TjarkG/Anemometer/README.md

# Anemometer

Ultrasonic Anemometer based on an cheap distance Sensors
