TjarkG/Anemometer/PCB/Hc_sr04_schematics.png

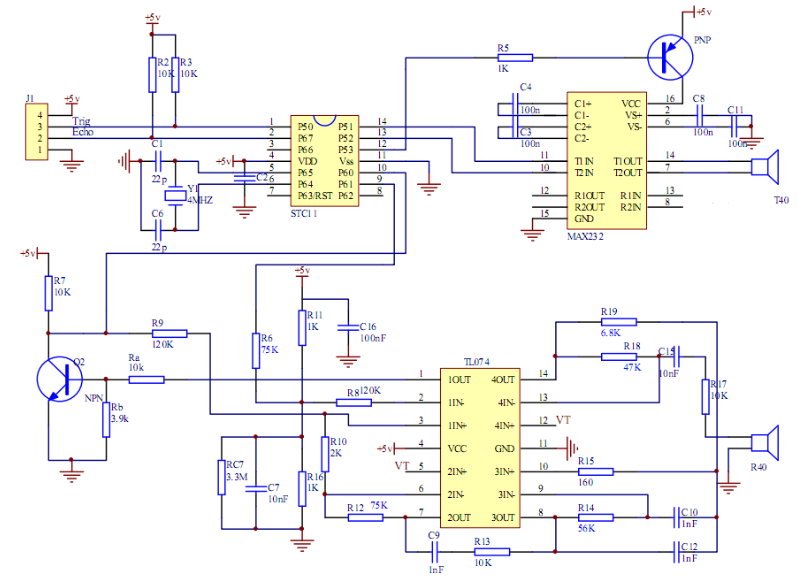
PCB/Hc_sr04_schematics.png
