TjarkG/Anemometer/PCB/HC-SR04 Case.stl

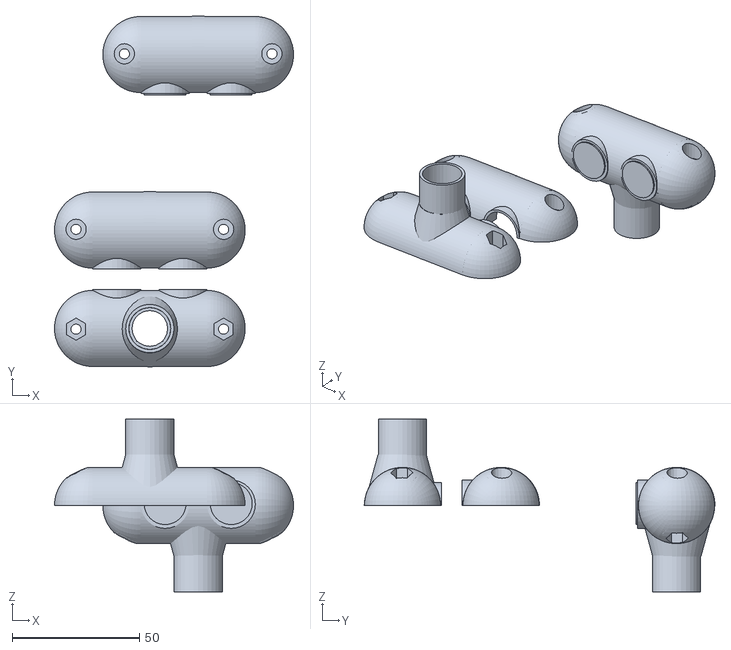
[picture p2: CAD file, 2022-01-11]
PCB/HC-SR04 Case.stl
94.0 x 138.0 x 68.0
