TjarkG/Anemometer/PCB/AnemometerTHT.brd

## EAGLE design PCB/AnemometerTHT.brd (2021-12-28)

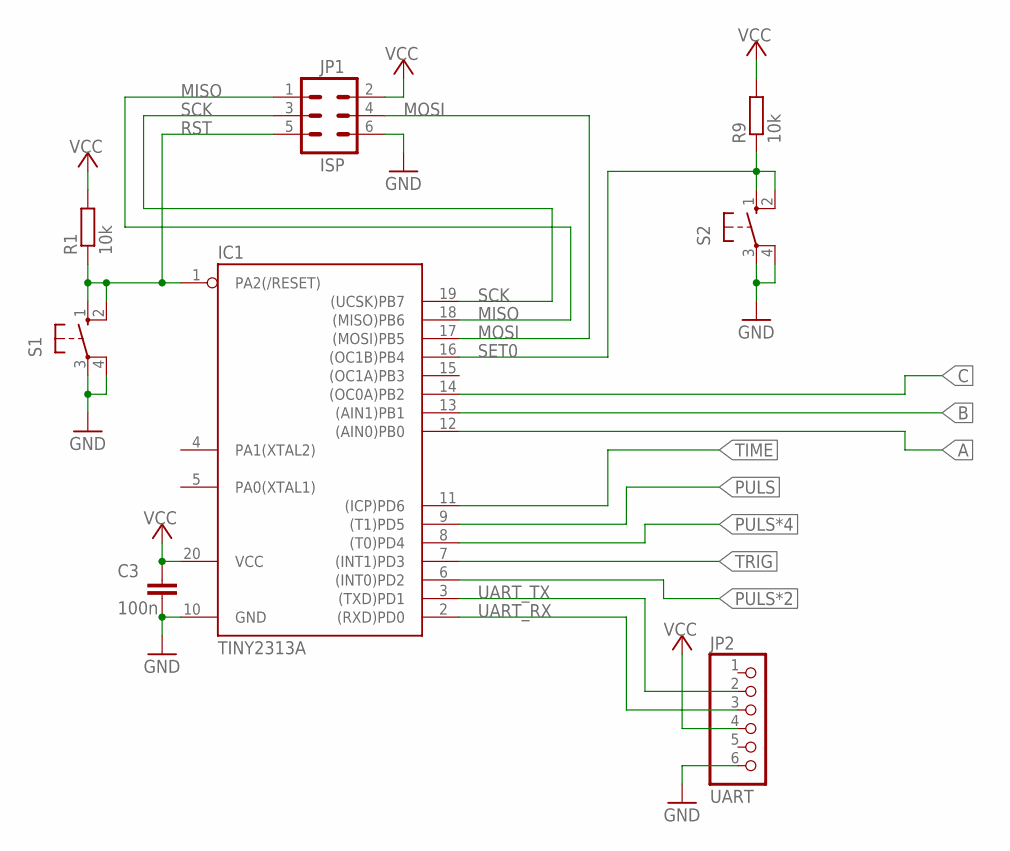
[picture p3: schematic AnemometerTHT.sch, sheet 1, microcontroller]

Parts:
C3: 100n; C050-030X075
IC1: TINY2313A; DIL20
JP1: ISP; ML6
JP2: UART; 1X06
R1, R9: 10k; 0204/7
S1, S2: 10-XX; B3F-10XX

Connections:
A: IC1.12 ((AIN0)PB0); also elsewhere on the board
B: IC1.13 ((AIN1)PB1); also elsewhere on the board
C: IC1.14 ((OC0A)PB2); also elsewhere on the board
GND: C3.2, IC1.10 (GND), JP1.6, JP2.6, S1.3, S1.4 (P1), S2.3, S2.4 (P1); also elsewhere on the board
MISO: IC1.18 ((MISO)PB6), JP1.1
MOSI: IC1.17 ((MOSI)PB5), JP1.4
PULS: IC1.9 ((T1)PD5); also elsewhere on the board
PULS*2: IC1.6 ((INT0)PD2); also elsewhere on the board
PULS*4: IC1.8 ((T0)PD4); also elsewhere on the board
RST: IC1.1 (PA2(/RESET)), JP1.5, R1.1, S1.1 (S), S1.2 (S1)
SCK: IC1.19 ((UCSK)PB7), JP1.3
SET0: IC1.16 ((OC1B)PB4), R9.1, S2.1 (S), S2.2 (S1)
TIME: IC1.11 ((ICP)PD6); also elsewhere on the board
TRIG: IC1.7 ((INT1)PD3); also elsewhere on the board
UART_RX: IC1.2 ((RXD)PD0), JP2.3
UART_TX: IC1.3 ((TXD)PD1), JP2.2
VCC: C3.1, IC1.20 (VCC), JP1.2, JP2.4, R1.2, R9.2; also elsewhere on the board

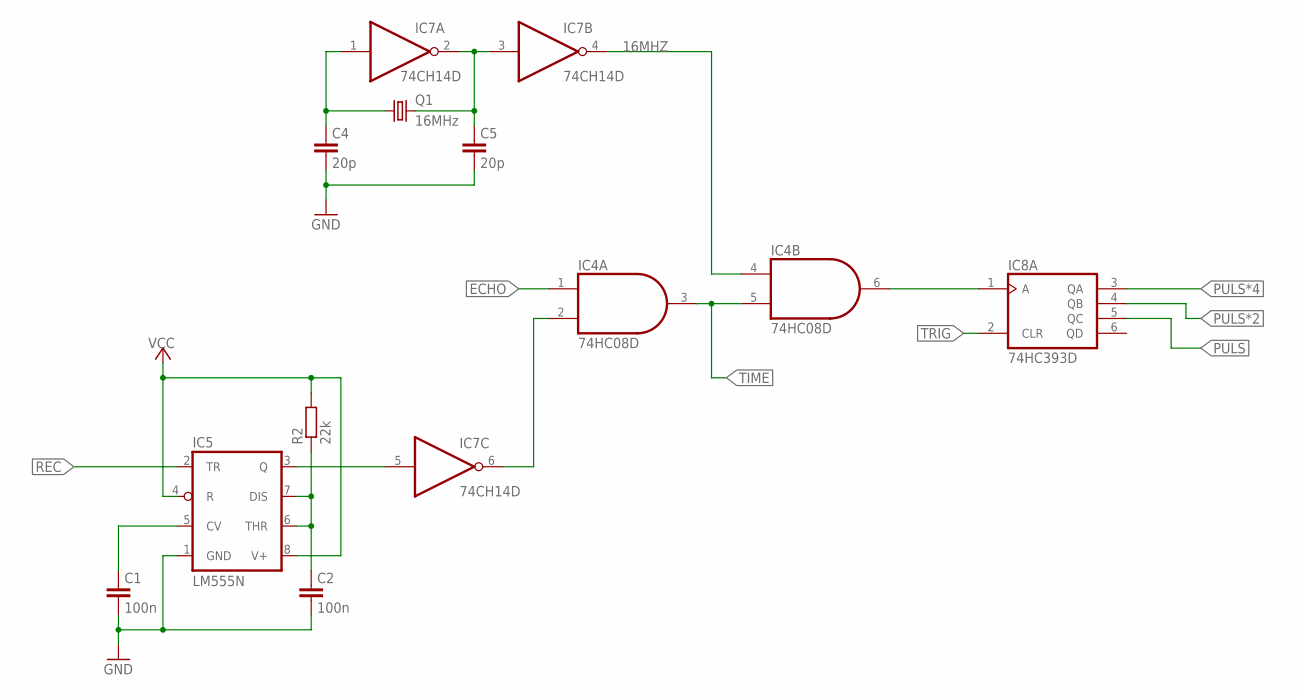
[picture p4: schematic AnemometerTHT.sch, sheet 2, puls generation]

Parts:
C1, C2: 100n; C050-030X075
C4, C5: 20p; C050-030X075
IC4: 74HC08D; DIL14
IC5: LM555N; DIL08
IC7: 74CH14D; DIL14
IC8: 74HC393D; DIL14
Q1: 16MHz; HC49U70
R2: 22k; 0204/7

Connections:
16MHZ: IC4.4 (I0), IC7.4 (O)
ECHO: IC4.1 (I0); also elsewhere on the board
GND: C1.2, C2.2, C4.2, C5.2, IC5.1 (GND); also elsewhere on the board
unnamed: IC5.3 (Q), IC7.5 (I)
unnamed: C1.1, IC5.5 (CV)
unnamed: IC4.6 (O), IC8.1 (A)
unnamed: C2.1, IC5.6 (THR), IC5.7 (DIS), R2.1
unnamed: IC4.2 (I1), IC7.6 (O)
unnamed: C4.1, IC7.1 (I), Q1.1
unnamed: C5.1, IC7.2 (O), IC7.3 (I), Q1.2
PULS: IC8.5 (QC); also elsewhere on the board
PULS*2: IC8.4 (QB); also elsewhere on the board
PULS*4: IC8.3 (QA); also elsewhere on the board
REC: IC5.2 (TR); also elsewhere on the board
TIME: IC4.3 (O), IC4.5 (I1); also elsewhere on the board
TRIG: IC8.2 (CLR); also elsewhere on the board
VCC: IC5.4 (R), IC5.8 (V+), R2.2; also elsewhere on the board

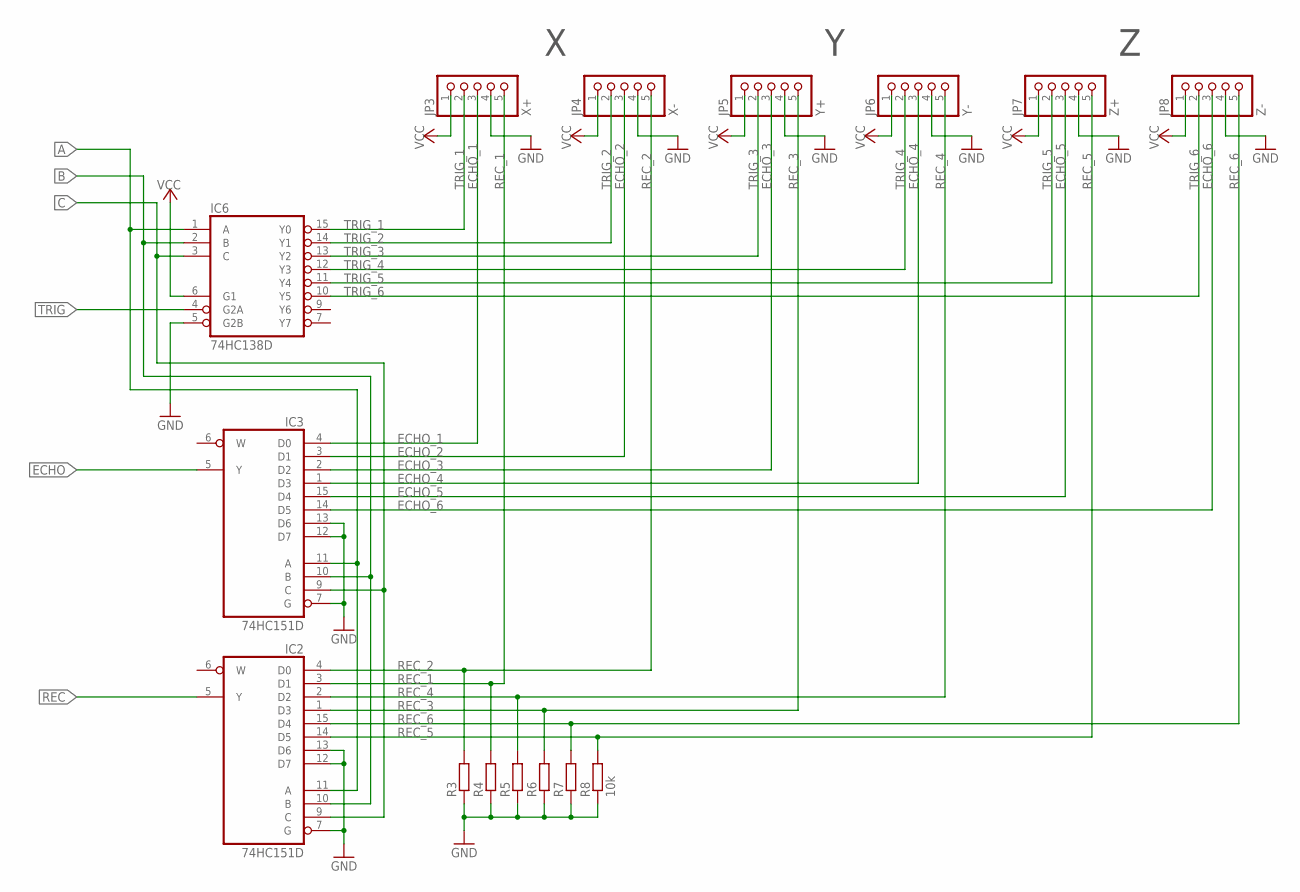
[picture p5: schematic AnemometerTHT.sch, sheet 3, multiplexer]

Parts:
IC2, IC3: 74HC151D; DIL16
IC6: 74HC138D; DIL16
JP3: X+; 1X05
JP4: X-; 1X05
JP5: Y+; 1X05
JP6: Y-; 1X05
JP7: Z+; 1X05
JP8: Z-; 1X05
R3, R4, R5, R6, R7, R8: 10k; 0204/7

Connections:
A: IC2.11 (A), IC3.11 (A), IC6.1 (A); also elsewhere on the board
B: IC2.10 (B), IC3.10 (B), IC6.2 (B); also elsewhere on the board
C: IC2.9 (C), IC3.9 (C), IC6.3 (C); also elsewhere on the board
ECHO: IC3.5 (Y); also elsewhere on the board
ECHO_1: IC3.4 (D0), JP3.3
ECHO_2: IC3.3 (D1), JP4.3
ECHO_3: IC3.2 (D2), JP5.3
ECHO_4: IC3.1 (D3), JP6.3
ECHO_5: IC3.15 (D4), JP7.3
ECHO_6: IC3.14 (D5), JP8.3
GND: IC2.7 (G), IC2.12 (D7), IC2.13 (D6), IC3.7 (G), IC3.12 (D7), IC3.13 (D6), IC6.5 (G2B), JP3.4, JP4.4, JP5.4, JP6.4, JP7.4, JP8.4, R3.1, R4.1, R5.1, R6.1, R7.1, R8.1; also elsewhere on the board
REC: IC2.5 (Y); also elsewhere on the board
REC_1: IC2.3 (D1), JP3.5, R4.2
REC_2: IC2.4 (D0), JP4.5, R3.2
REC_3: IC2.1 (D3), JP5.5, R6.2
REC_4: IC2.2 (D2), JP6.5, R5.2
REC_5: IC2.14 (D5), JP7.5, R8.2
REC_6: IC2.15 (D4), JP8.5, R7.2
TRIG: IC6.4 (G2A); also elsewhere on the board
TRIG_1: IC6.15 (Y0), JP3.2
TRIG_2: IC6.14 (Y1), JP4.2
TRIG_3: IC6.13 (Y2), JP5.2
TRIG_4: IC6.12 (Y3), JP6.2
TRIG_5: IC6.11 (Y4), JP7.2
TRIG_6: IC6.10 (Y5), JP8.2
VCC: IC6.6 (G1), JP3.1, JP4.1, JP5.1, JP6.1, JP7.1, JP8.1; also elsewhere on the board

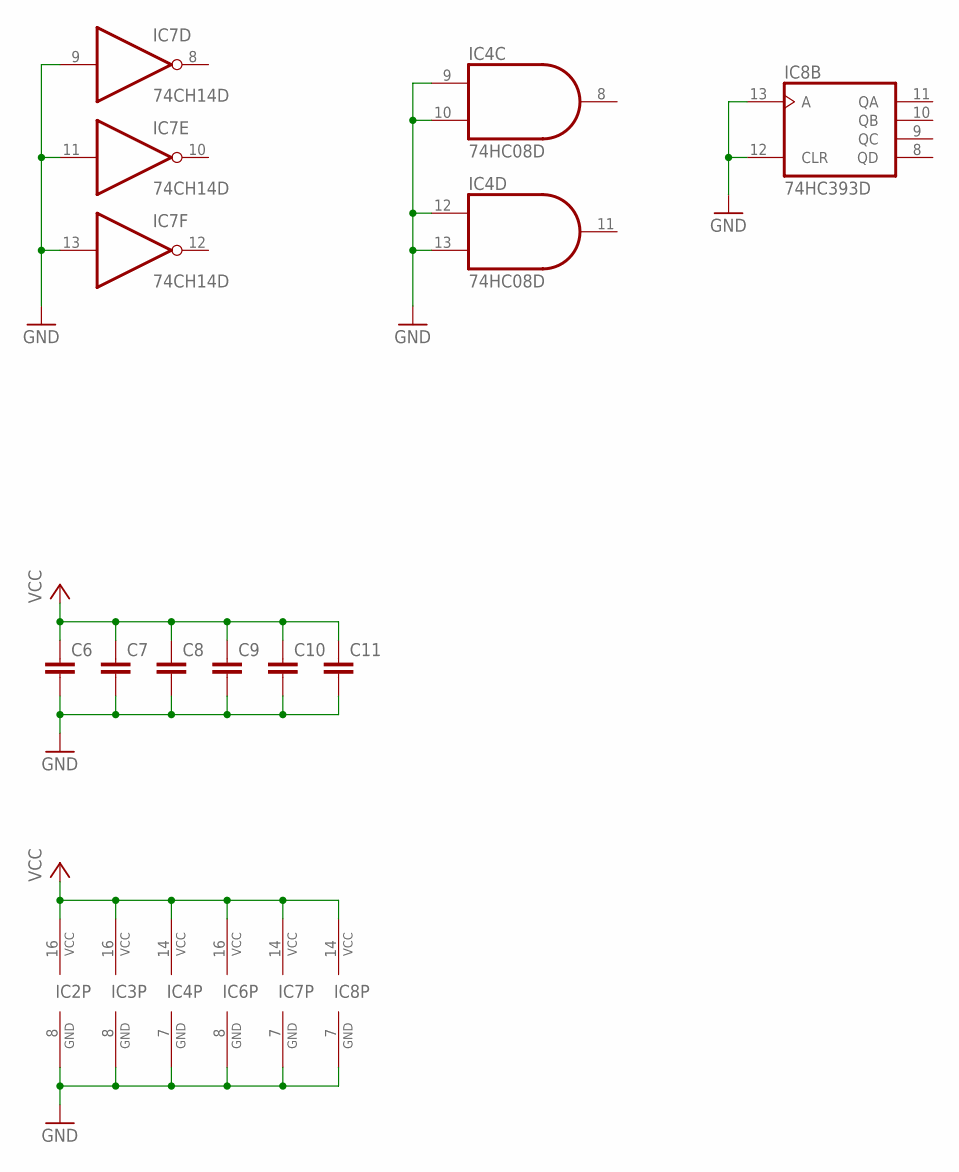
[picture p6: schematic AnemometerTHT.sch, sheet 4, power / unused gates]

Parts:
C6, C7, C8, C9, C10, C11: C-EU050-030X075; C050-030X075
IC2, IC3: 74HC151D; DIL16
IC4: 74HC08D; DIL14
IC6: 74HC138D; DIL16
IC7: 74CH14D; DIL14
IC8: 74HC393D; DIL14

Connections:
GND: C6.2, C7.2, C8.2, C9.2, C10.2, C11.2, IC2.8 (GND), IC3.8 (GND), IC4.7 (GND), IC4.9 (I0), IC4.10 (I1), IC4.12 (I0), IC4.13 (I1), IC6.8 (GND), IC7.7 (GND), IC7.9 (I), IC7.11 (I), IC7.13 (I), IC8.7 (GND), IC8.12 (CLR), IC8.13 (A); also elsewhere on the board
VCC: C6.1, C7.1, C8.1, C9.1, C10.1, C11.1, IC2.16 (VCC), IC3.16 (VCC), IC4.14 (VCC), IC6.16 (VCC), IC7.14 (VCC), IC8.14 (VCC); also elsewhere on the board

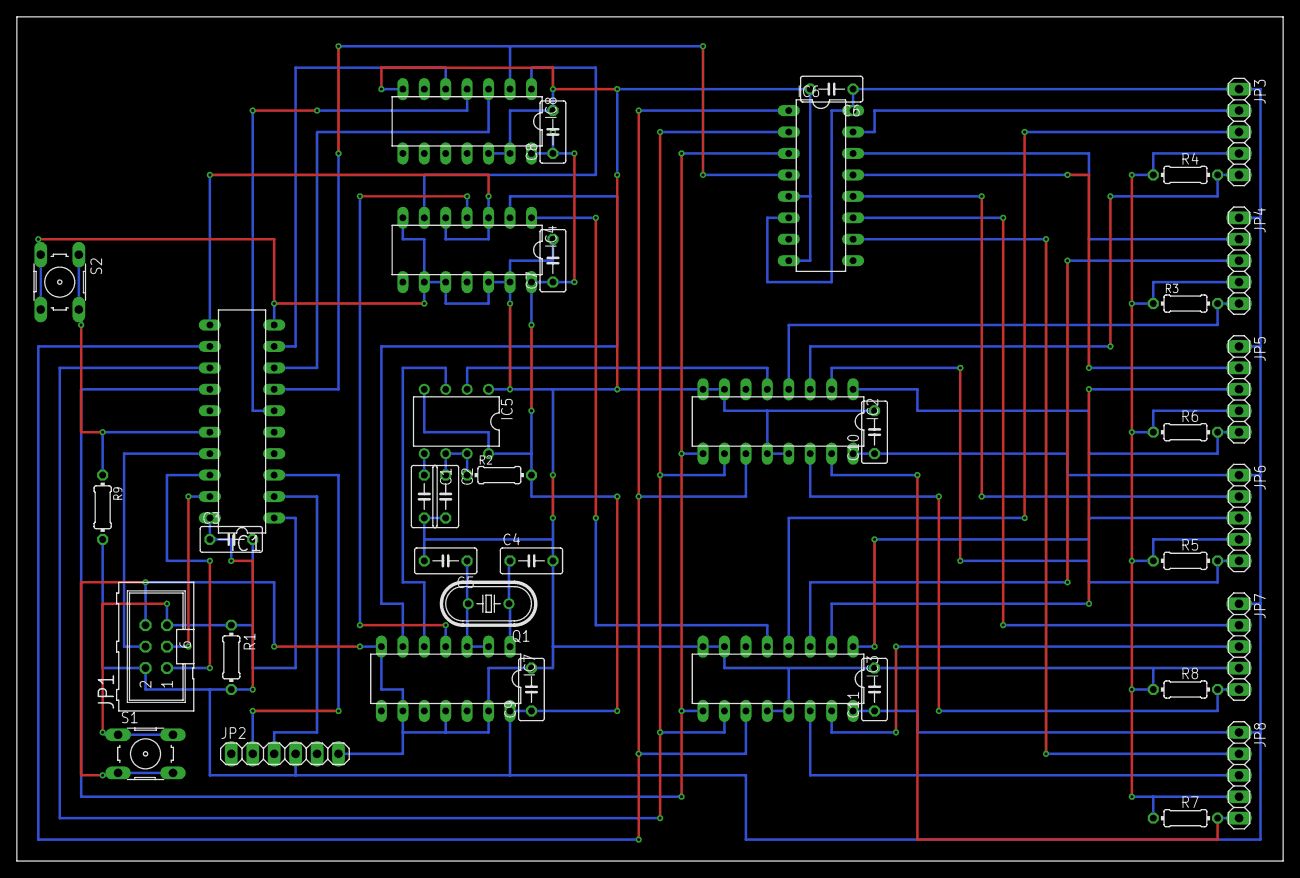
[picture p7: board AnemometerTHT.brd from above]

Board: 2 copper layers, 150.0 x 100.0 mm, 39 parts (0 on the bottom side), 45 nets.
