TjarkG/Anemometer/(commit log)

2021-11-23 added Sensor Time Function
2021-11-24 added velocity output
2021-11-24 added UART Header and Schematic
    [Anemometer.sch]
2021-11-28 added Houskeeping to Schematic
    [Anemometer.sch]
2021-12-02 changed timekeeping to hardware timer
    [Anemometer.sch]
2021-12-04 added input Logic to Schematic
    [Anemometer.sch]
2021-12-04 changed messurment methode to half external counter
    [Anemometer.sch]
2021-12-05 added timeout protection
    [Anemometer.sch]
2021-12-05 messured ticks for different differences
    [Time to Ticks.ods]
2021-12-06 added mean function
    [Time to Ticks.ods]
2021-12-06 added THT variant with board
    [AnemometerTHT.brd, AnemometerTHT.sch]
2021-12-12 added resistors to make clock run reliable
    [Anemometer.sch, AnemometerTHT.brd, AnemometerTHT.sch]
2021-12-19 moved pcb files into folder
    [Anemometer.sch, AnemometerTHT.brd, AnemometerTHT.sch]
2021-12-22 realized that i inverted the wrong signal
    [AnemometerTHT.brd, AnemometerTHT.sch]
2021-12-23 changed code to read out multiple sensors
2021-12-23 corrected multilexer addressing
    [AnemometerTHT.brd]
2021-12-25 added velocity calculation
2021-12-26 made printing negatives possible
2021-12-27 added offset corection
    [AnemometerTHT.brd, AnemometerTHT.sch]
2021-12-27 removed outdated schematic
    [Anemometer.sch]
2021-12-28 moved puls counter to in/4
    [AnemometerTHT.brd, AnemometerTHT.sch]
2022-01-11 added model of Sensor Case
    [HC-SR04 Case.stl]
